wheeler-microfluidics/sketchup___120-channel_device_connector/stl/top_plate.stl

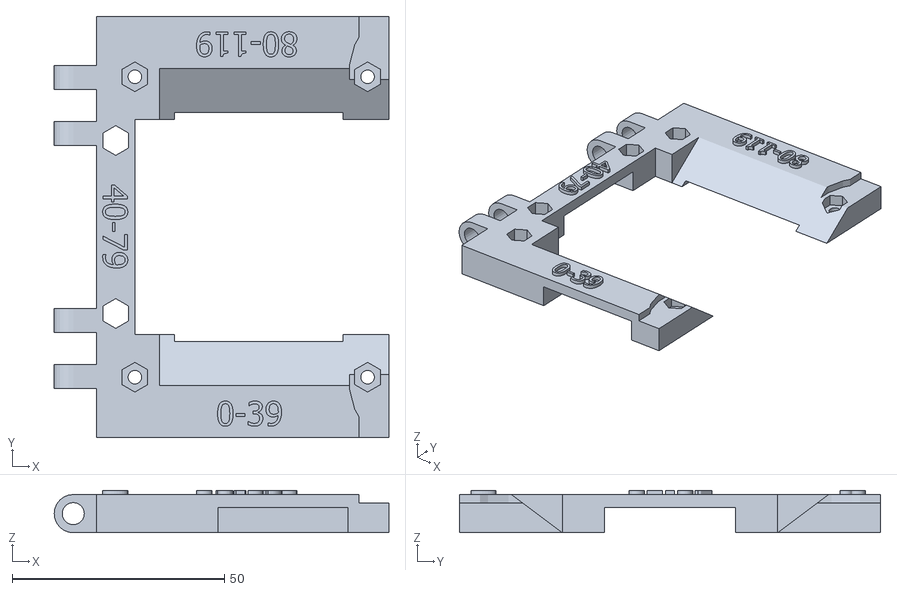
[picture p1: CAD file, 2014-06-11]
stl/top_plate.stl
78.8 x 99.1 x 10.0
