wheeler-microfluidics/sketchup___120-channel_device_connector/stl/base_plate.stl

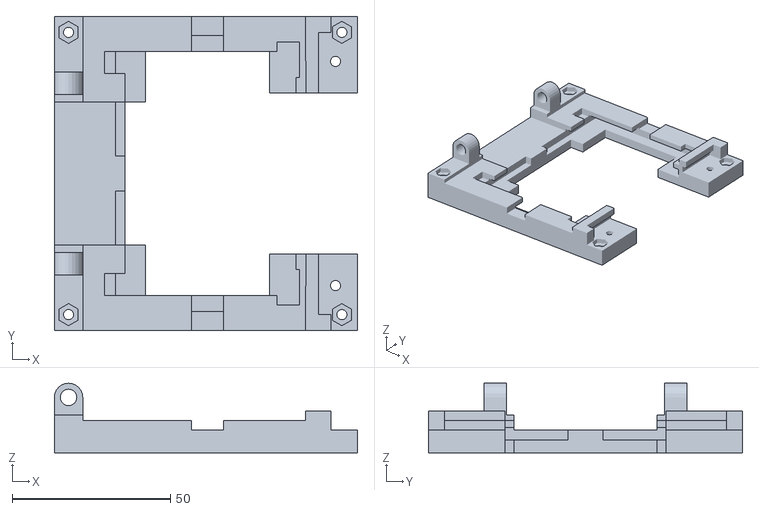
[picture p2: CAD file, 2014-06-11]
stl/base_plate.stl
95.8 x 99.2 x 22.0
