wheeler-microfluidics/sketchup___120-channel_device_connector/stl/hinge_pin.stl

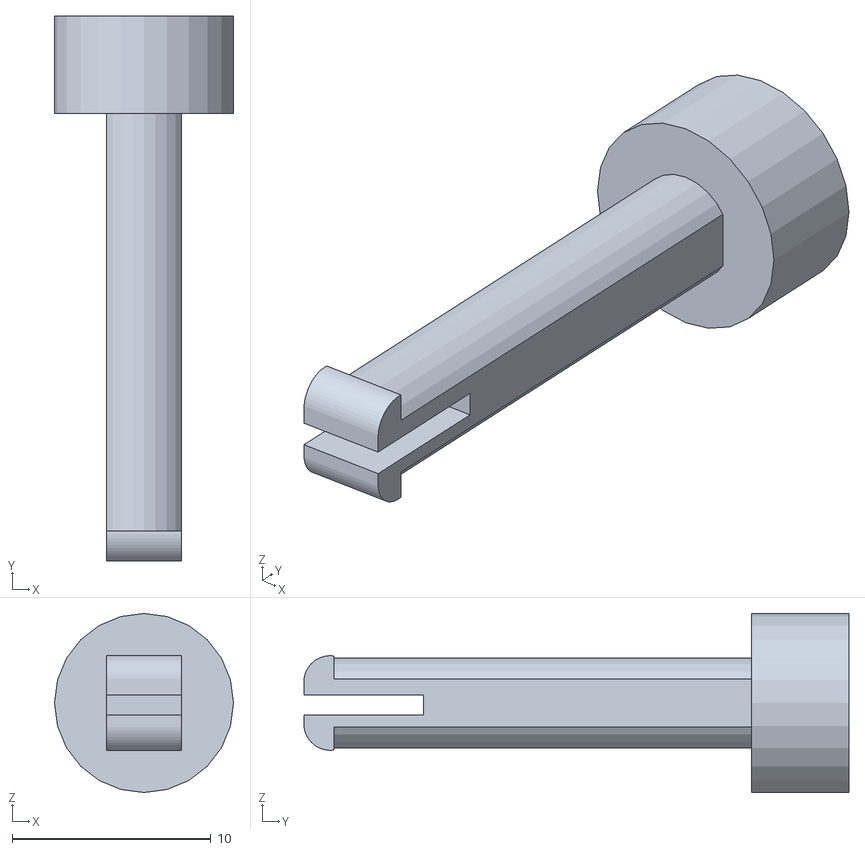
[picture p3: CAD file, 2014-05-30]
stl/hinge_pin.stl
9.00 x 27.4 x 9.00
