wheeler-microfluidics/sketchup___120-channel_device_connector/stl/L_clasp.stl

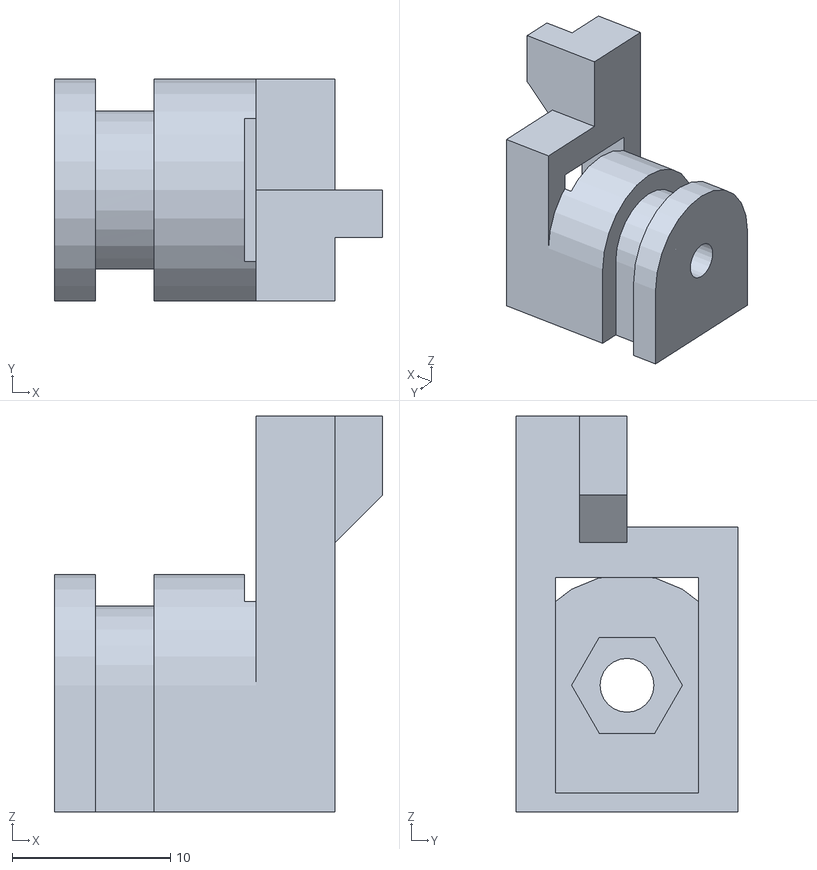
[picture p4: CAD file, 2014-01-13]
stl/L_clasp.stl
20.7 x 14.0 x 25.0
