wheeler-microfluidics/sketchup___120-channel_device_connector/stl/L-camera_arm.stl

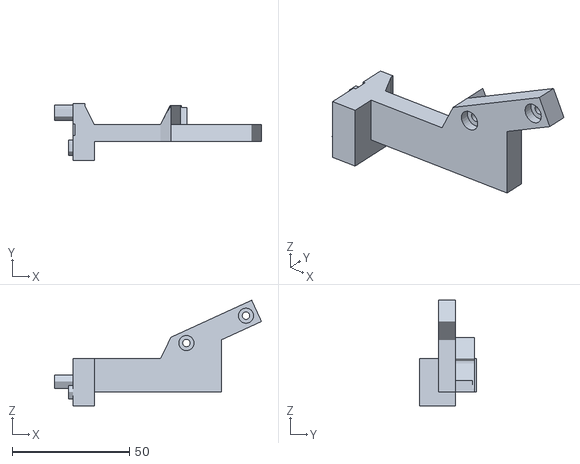
[picture p5: CAD file, 2014-01-13]
stl/L-camera_arm.stl
88.4 x 24.5 x 45.1
