wheeler-microfluidics/sketchup___120-channel_device_connector/stl/camera_holder.stl

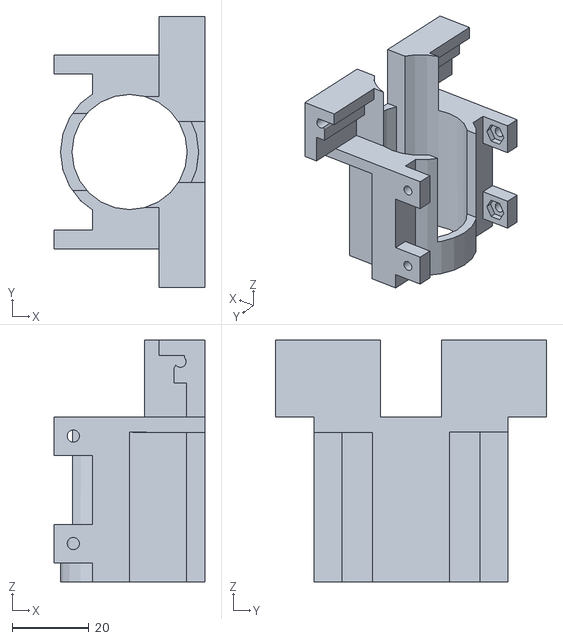
[picture p6: CAD file, 2014-01-13]
stl/camera_holder.stl
39.3 x 70.7 x 63.0
