wheeler-microfluidics/sketchup___120-channel_device_connector/(list of files, cad)

Other CAD files:
stl/R-camera_arm.stl
stl/R_clasp.stl
120-channel device connector.skp
