wheeler-microfluidics/sketchup___120-channel_device_connector/(commit log)

2013-09-24 [WIP] Raise upper structure 1mm, add device guide
    [pogo-pin fixture.skp]
2013-09-24 Split device guide into 4 parts, add cutout on...
    Split device guide into 4 parts.
    Add cutout on bottom plate around device area. Add an extra gap at the front
    of the device to allow clearance for tweezers, etc.
    [pogo-pin fixture.skp]
2013-09-24 Add cut-out at back of device for cable to lay in
    [pogo-pin fixture.skp]
2013-09-24 Add flattend/exploded SketchUp + SVG
    [pogo-pin fixture-exploded.skp, pogo-pin fixture-flattened.skp, pogo-pin fixture.skp]
2013-09-27 Add first draft of 3D-printed top-plate
    [top plate.skp]
2013-09-27 Add draft device guides for 3d print
    [top plate.skp]
2013-09-27 [WIP] 3d printed draft, needs holes in bottom
    [top plate.skp]
2013-09-27 Move 3d-printer holder design to new file
    [pogo-pin fixture-3d-print-version.skp, pogo-pin fixture.skp, top plate.skp]
2013-10-07 Set camera alignment to fixed position
    [Camera holder.skp]
2013-10-07 Add brackets for mounting diffuser wedge
    [Camera holder.skp]
2013-10-07 Add new light diffuser box
    [Camera holder.skp]
2013-10-07 [WIP] Diffuser conflicsts with base latches
    [Camera holder.skp]
2013-10-07 Fix conflicts b/w diffuser and latches
    [Camera holder.skp]
2013-10-11 [NB] Remove diffuser, replace with new camera-h...
    Remove light-diffuser box, replace with new camera-holder, mounted using side
    arms, rather than acrylic side-plates.
    __NB__ The new camera-holder has a flat face where a light-source _(e.g., LED
    array)_ may be mounted. The top of the camera-holder has extruded plates on
    either side, providing a place to attach a piece of paper using clips. The
    piece of paper can then be draped over the device, with the opposite end of the
    piece of paper tucked under the front of the base plate, such that the paper
    diffuses the light from the upward-facing light-source down to the device.
    [Camera holder.skp, Full base plate.skp, L-clasp.skp]
2013-10-11 Make front of top-plate wedged to reduce relfec...
    Make front of top-plate wedged to reduce the relfection of the top-plate on the
    device surface.
    [Camera holder.skp]
2013-10-16 Add cut-aways to acrylic window plates.
    [Camera holder.skp, Full base plate.skp, L-clasp.skp]
2013-10-17 Add clasp with notch, merge clasps into base-pl...
    Add clasp prototype with notch on the front to prevent lift-off when the
    clasp is engaged.
    Merge clasps into base-plate file.
    [Camera holder.skp, Full base plate.skp, L-clasp.skp, R-clasp.skp, Top plate.skp]
2013-10-17 Clear out old files before merging with new design
    [pogo-pin fixture-3d-print-version.skp, pogo-pin fixture-exploded.skp, pogo-pin fixture-flattened.skp, pogo-pin fixture.skp, top plate.skp]
2013-10-25 Modify front clasps to prevent loosening/prying
    Modify front clasps _(which rotate to hold down the top-plate)_ to
    prevent them loosening. This is accomplished by adding a ridge that the
    foot of each clasp slides under to prevent the clasp from prying upwards
    due to the force from the top-plate pushing up.
    [Camera holder.skp, Full base plate.skp, Top plate.skp]
2013-10-25 Rename SketchUp files to use unix-friendly names
    [base_plate.skp, camera_holder.skp, top_plate.skp]
2014-01-13 Combine all parts into single sketchup model and add stl/svgs
    [120-channel device connector.skp, L-camera_arm.stl, L_clasp.stl, R-camera_arm.stl, R_clasp.stl, base_plate.skp, base_plate.stl, camera_holder.skp]
2014-05-30 Add pogo-pin solder pads clearance to top-plate
    Add clearance room on top-plate to allow space for pogo-pin solder pads.
    [120-channel device connector.skp]
2014-05-30 Thicken top/base-plate hinges by ~2x
    [120-channel device connector.skp]
2014-05-30 Thicken top/base-plate hinges by 1.6mm
    [120-channel device connector.skp]
2014-05-30 Update STL files for top/base-plate, hinge-pins
    [120-channel device connector.skp, base_plate.stl, hinge_pin.stl, top_plate.stl]
2014-05-30 Increase gap for base-plate windows, thicken base
    Use multiples of 0.4mm for base-plate acrylic window gap, and thickness
    from floor to bottom of window gap. This should hopefully help match
    the MakerBot Replicator 2 print resolution.
    [120-channel device connector.skp, base_plate.stl]
2014-05-30 Increase bottom rest gap width for camera holder
    Increase the width of the gap where the camera-holder rests in the
    holder arms. This provides more tolerance for printing variations when
    fitting the camera-holder.
    [120-channel device connector.skp, hinge_pin.stl]
2014-06-11 Add more clearance for pogo-pins on top plate
    [120-channel device connector.skp, base_plate.stl, top_plate.stl]
